duydat291007/flywire-fpga-accelerator/docs/img/dashboard_offline_food.png

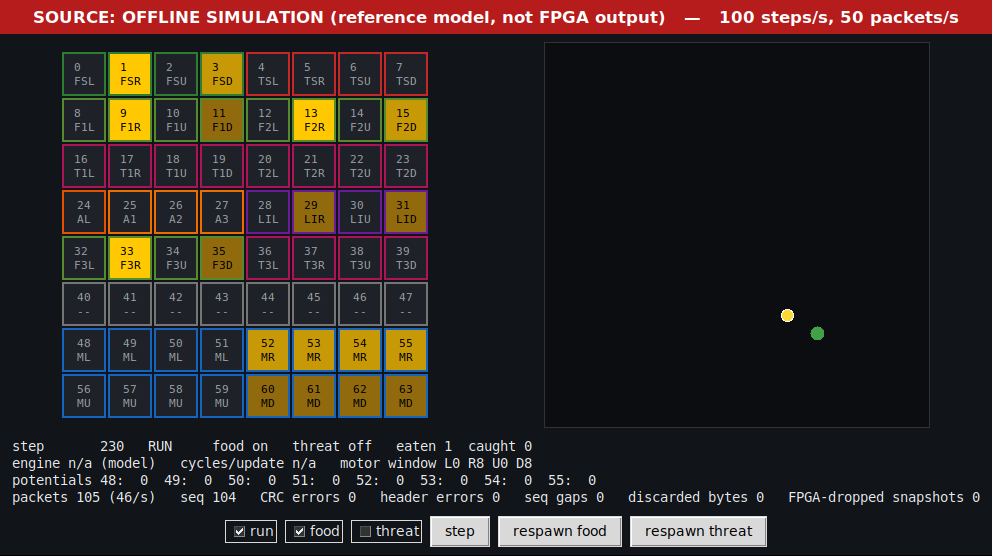
docs/img/dashboard_offline_food.png
