duydat291007/flywire-fpga-accelerator/constraints/basys3.xdc

## basys3.xdc - constraints for basys3_top
## Pins copied from Digilent's Basys-3-Master.xdc (github.com/Digilent/digilent-xdc,
## retrieved 2026-09-30). Only the ports used by basys3_top are enabled.
## UART naming is from the FPGA's point of view: RsTx (A18) is an FPGA OUTPUT
## driving the USB-UART bridge's receive line; RsRx (B18) is unused in v1.

## Clock: 100 MHz
set_property -dict { PACKAGE_PIN W5   IOSTANDARD LVCMOS33 } [get_ports clk]
create_clock -add -name sys_clk_pin -period 10.00 -waveform {0 5} [get_ports clk]

## Switches
set_property -dict { PACKAGE_PIN V17  IOSTANDARD LVCMOS33 } [get_ports {sw[0]}]
set_property -dict { PACKAGE_PIN V16  IOSTANDARD LVCMOS33 } [get_ports {sw[1]}]
set_property -dict { PACKAGE_PIN W16  IOSTANDARD LVCMOS33 } [get_ports {sw[2]}]
set_property -dict { PACKAGE_PIN W17  IOSTANDARD LVCMOS33 } [get_ports {sw[3]}]
set_property -dict { PACKAGE_PIN W15  IOSTANDARD LVCMOS33 } [get_ports {sw[4]}]
set_property -dict { PACKAGE_PIN V15  IOSTANDARD LVCMOS33 } [get_ports {sw[5]}]
set_property -dict { PACKAGE_PIN W14  IOSTANDARD LVCMOS33 } [get_ports {sw[6]}]
set_property -dict { PACKAGE_PIN W13  IOSTANDARD LVCMOS33 } [get_ports {sw[7]}]
set_property -dict { PACKAGE_PIN V2   IOSTANDARD LVCMOS33 } [get_ports {sw[8]}]
set_property -dict { PACKAGE_PIN T3   IOSTANDARD LVCMOS33 } [get_ports {sw[9]}]
set_property -dict { PACKAGE_PIN T2   IOSTANDARD LVCMOS33 } [get_ports {sw[10]}]
set_property -dict { PACKAGE_PIN R3   IOSTANDARD LVCMOS33 } [get_ports {sw[11]}]
set_property -dict { PACKAGE_PIN W2   IOSTANDARD LVCMOS33 } [get_ports {sw[12]}]
set_property -dict { PACKAGE_PIN U1   IOSTANDARD LVCMOS33 } [get_ports {sw[13]}]
set_property -dict { PACKAGE_PIN T1   IOSTANDARD LVCMOS33 } [get_ports {sw[14]}]
set_property -dict { PACKAGE_PIN R2   IOSTANDARD LVCMOS33 } [get_ports {sw[15]}]

## LEDs
set_property -dict { PACKAGE_PIN U16  IOSTANDARD LVCMOS33 } [get_ports {led[0]}]
set_property -dict { PACKAGE_PIN E19  IOSTANDARD LVCMOS33 } [get_ports {led[1]}]
set_property -dict { PACKAGE_PIN U19  IOSTANDARD LVCMOS33 } [get_ports {led[2]}]
set_property -dict { PACKAGE_PIN V19  IOSTANDARD LVCMOS33 } [get_ports {led[3]}]
set_property -dict { PACKAGE_PIN W18  IOSTANDARD LVCMOS33 } [get_ports {led[4]}]
set_property -dict { PACKAGE_PIN U15  IOSTANDARD LVCMOS33 } [get_ports {led[5]}]
set_property -dict { PACKAGE_PIN U14  IOSTANDARD LVCMOS33 } [get_ports {led[6]}]
set_property -dict { PACKAGE_PIN V14  IOSTANDARD LVCMOS33 } [get_ports {led[7]}]
set_property -dict { PACKAGE_PIN V13  IOSTANDARD LVCMOS33 } [get_ports {led[8]}]
set_property -dict { PACKAGE_PIN V3   IOSTANDARD LVCMOS33 } [get_ports {led[9]}]
set_property -dict { PACKAGE_PIN W3   IOSTANDARD LVCMOS33 } [get_ports {led[10]}]
set_property -dict { PACKAGE_PIN U3   IOSTANDARD LVCMOS33 } [get_ports {led[11]}]
set_property -dict { PACKAGE_PIN P3   IOSTANDARD LVCMOS33 } [get_ports {led[12]}]
set_property -dict { PACKAGE_PIN N3   IOSTANDARD LVCMOS33 } [get_ports {led[13]}]
set_property -dict { PACKAGE_PIN P1   IOSTANDARD LVCMOS33 } [get_ports {led[14]}]
set_property -dict { PACKAGE_PIN L1   IOSTANDARD LVCMOS33 } [get_ports {led[15]}]

## Buttons
set_property -dict { PACKAGE_PIN U18  IOSTANDARD LVCMOS33 } [get_ports btnC]
set_property -dict { PACKAGE_PIN T18  IOSTANDARD LVCMOS33 } [get_ports btnU]
set_property -dict { PACKAGE_PIN W19  IOSTANDARD LVCMOS33 } [get_ports btnL]
set_property -dict { PACKAGE_PIN T17  IOSTANDARD LVCMOS33 } [get_ports btnR]

## USB-RS232 interface (FPGA transmit only)
set_property -dict { PACKAGE_PIN A18  IOSTANDARD LVCMOS33 } [get_ports RsTx]

## Asynchronous inputs: buttons and switches are synchronized by
## input_conditioner. They have no meaningful timing relationship to clk,
## so they are excluded from input-delay analysis. RsTx is a slow 115200-baud
## output whose timing is set by the baud counter, not the pad delay.
set_false_path -from [get_ports {btnC btnU btnL btnR sw[*]}]
set_false_path -to   [get_ports {led[*] RsTx}]

## Configuration
set_property CONFIG_VOLTAGE 3.3 [current_design]
set_property CFGBVS VCCO [current_design]

## Boot from the on-board Quad-SPI flash (as in Digilent's master XDC).
## Programming the flash (scripts/vivado/run_vivado.sh flash) and setting
## jumper JP1 to QSPI makes the design load by itself at power-on.
set_property BITSTREAM.GENERAL.COMPRESS TRUE [current_design]
set_property BITSTREAM.CONFIG.CONFIGRATE 33 [current_design]
set_property CONFIG_MODE SPIx4 [current_design]
