duydat291007/flywire-fpga-accelerator/(commit log)

2026-10-02 Systolic neural accelerator running a FlyWire fly circuit on Basys 3
    SystemVerilog systolic matrix-vector accelerator, LIF neural core and
    heading-based fly world running a 256-neuron FlyWire (FAFB v783)
    subcircuit on a Digilent Basys 3, with Python reference model,
    self-checking testbenches, SVA, UVM, mutation checks, Vivado scripts,
    UART telemetry and a live dashboard.
    [circuit_edges.csv, circuit_neurons.csv, results.csv]
2026-10-02 Timing fixes; serial and systolic both meet 100 MHz at 256 neurons
    [results.csv]
2026-10-03 Corner escape rule, boot from flash, wider timing margins
    [results.csv]
